aescuredo77/armpap/armpap_description/meshes/armpap/link_left01.stl

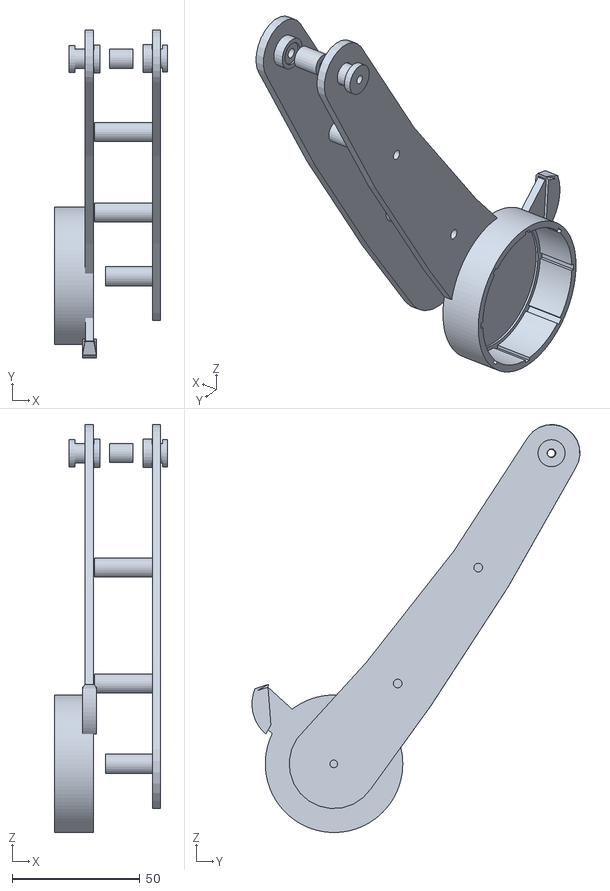
[picture p8: CAD file, 2021-03-23]
armpap_description/meshes/armpap/link_left01.stl
44.3 x 128.3 x 159.6
