aescuredo77/armpap/armpap_description/meshes/gripper/gripper_left.stl

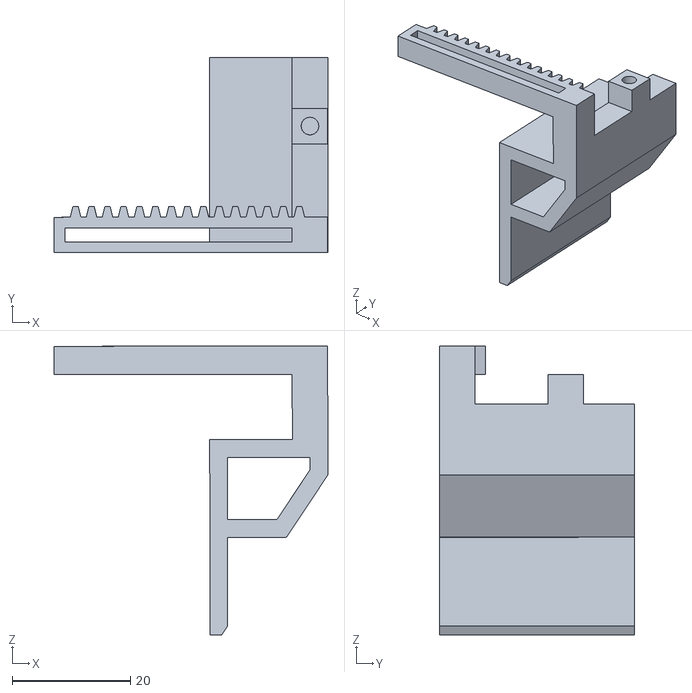
[picture p9: CAD file, 2021-03-23]
armpap_description/meshes/gripper/gripper_left.stl
46.2 x 33.0 x 48.8
