aescuredo77/armpap/armpap_description/meshes/armpap/motor_right.stl

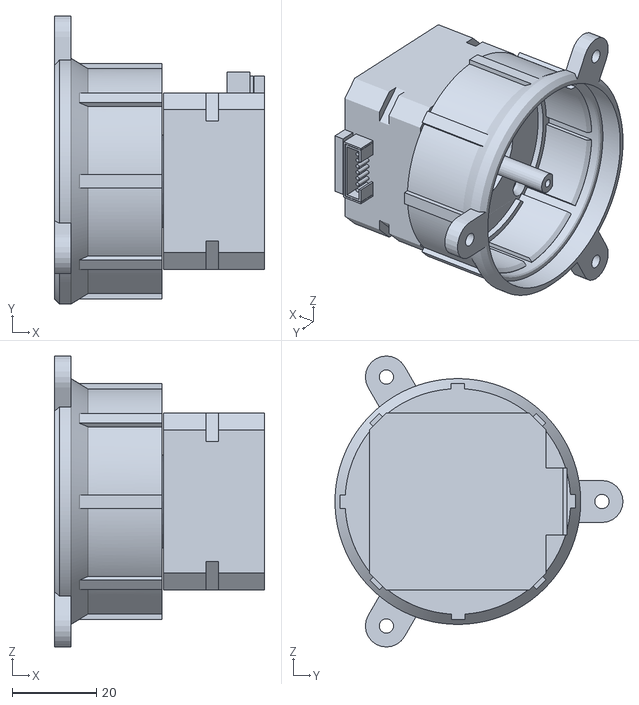
[picture p10: CAD file, 2021-03-23]
armpap_description/meshes/armpap/motor_right.stl
50.0 x 68.5 x 69.2
