aescuredo77/armpap/armpap_description/meshes/armpap/base_link.stl

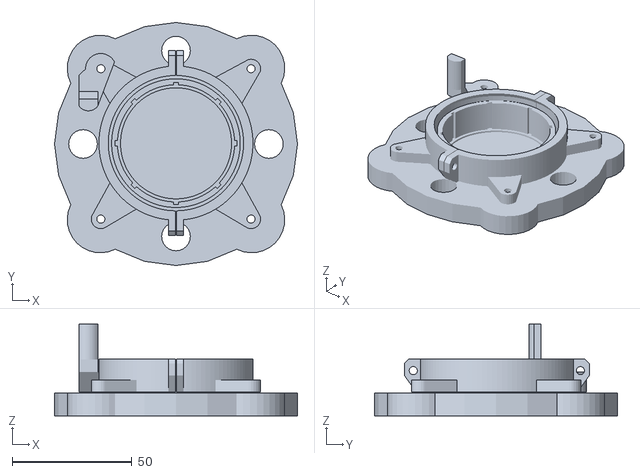
[picture p11: CAD file, 2021-03-23]
armpap_description/meshes/armpap/base_link.stl
101.6 x 101.6 x 38.4
