aescuredo77/armpap/armpap_description/meshes/gripper/gripper_base.stl

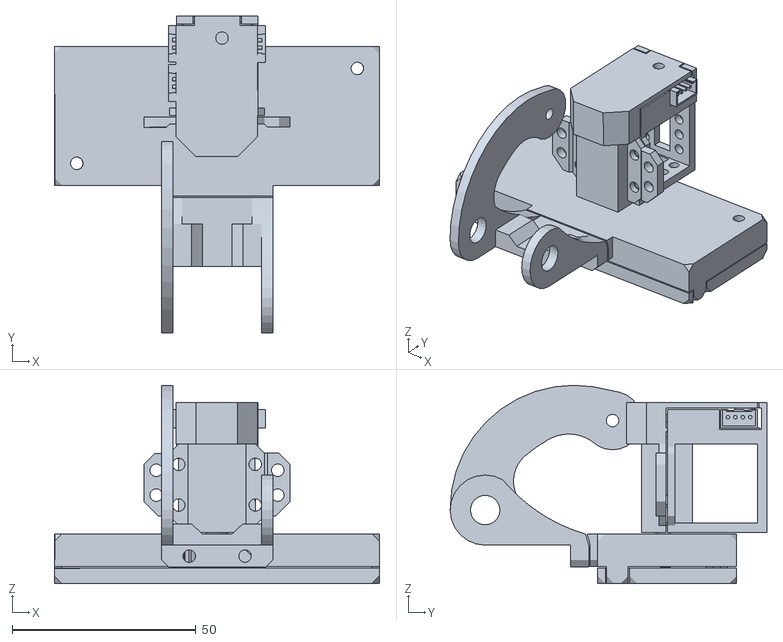
[picture p12: CAD file, 2021-03-23]
armpap_description/meshes/gripper/gripper_base.stl
88.3 x 86.1 x 53.9
