aescuredo77/armpap/armpap_description/meshes/armpap/link_right01.stl

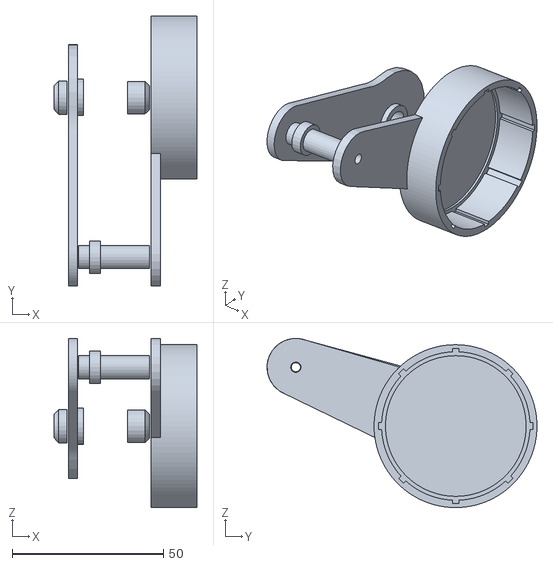
[picture p13: CAD file, 2021-03-23]
armpap_description/meshes/armpap/link_right01.stl
47.2 x 89.1 x 55.9
