aescuredo77/armpap/armpap_description/meshes/armpap/base_link00.stl

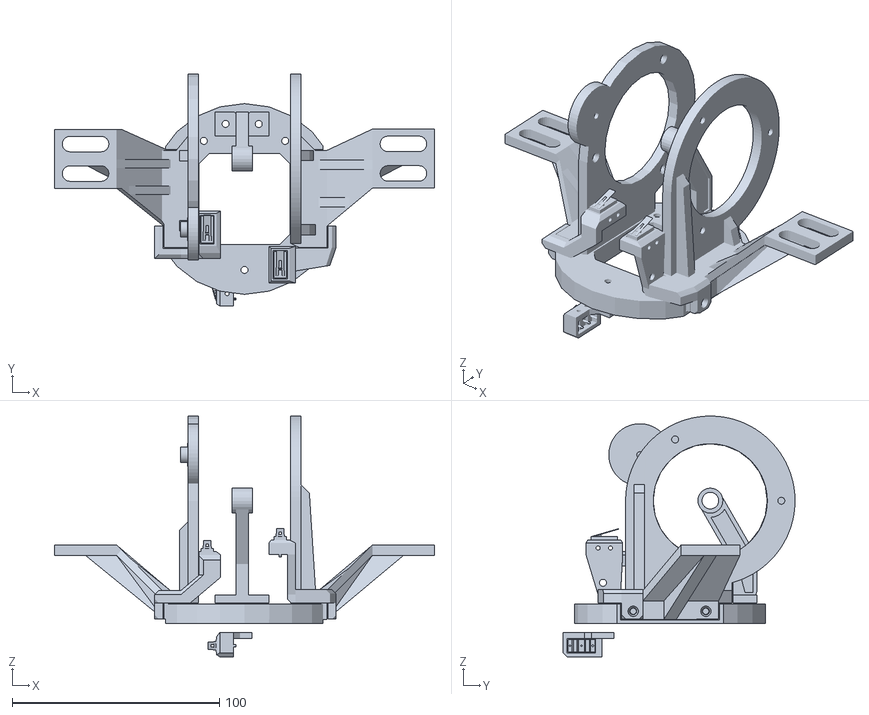
[picture p14: CAD file, 2021-03-23]
armpap_description/meshes/armpap/base_link00.stl
183.4 x 112.0 x 116.3
