aescuredo77/armpap/armpap_description/meshes/armpap/motor_base.stl

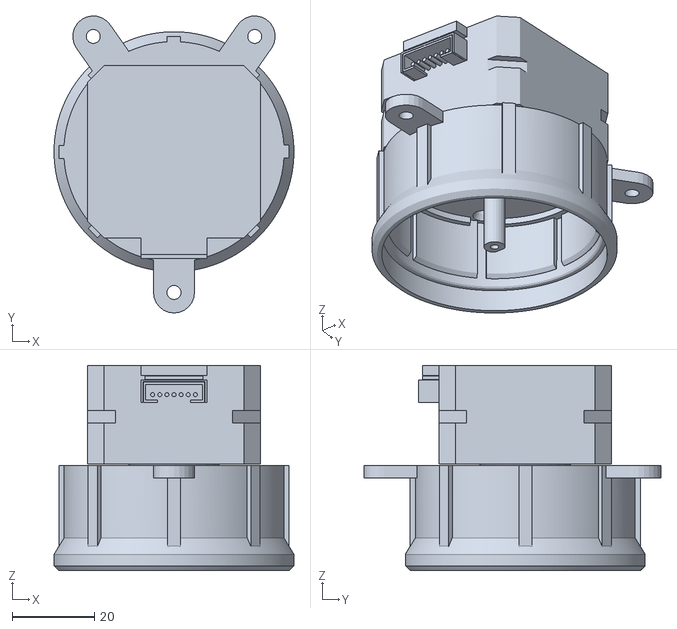
[picture p15: CAD file, 2021-03-23]
armpap_description/meshes/armpap/motor_base.stl
58.4 x 72.3 x 50.0
