aescuredo77/armpap/armpap_description/meshes/armpap/link_left02.stl

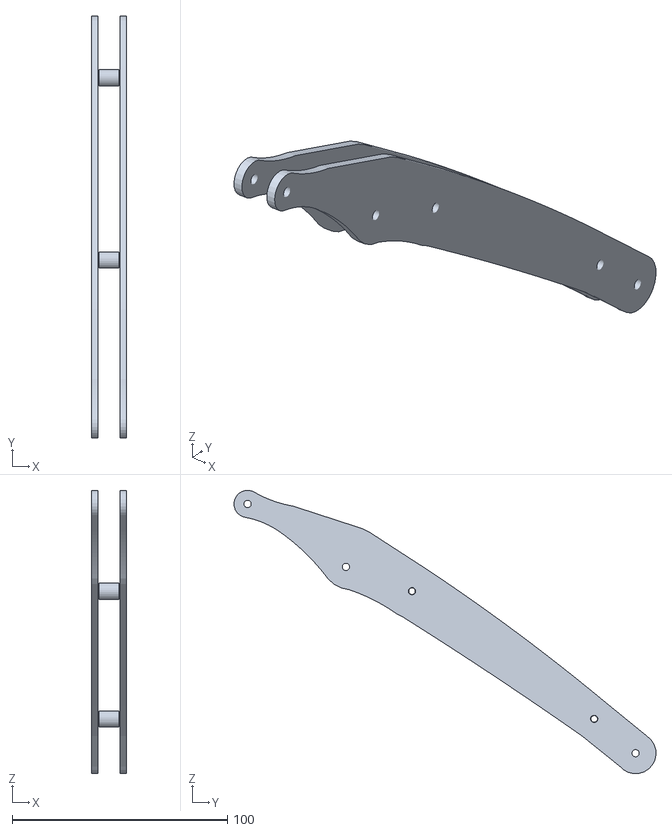
[picture p16: CAD file, 2021-03-23]
armpap_description/meshes/armpap/link_left02.stl
16.3 x 196.2 x 131.7
