aescuredo77/armpap/(list of files, cad)

Other CAD files:
armpap_description/meshes/gripper/gripper_right.stl
armpap_description/meshes/armpap/motor_left.stl
